prashantbhandary/mspmo-baord/images/3d-top.png

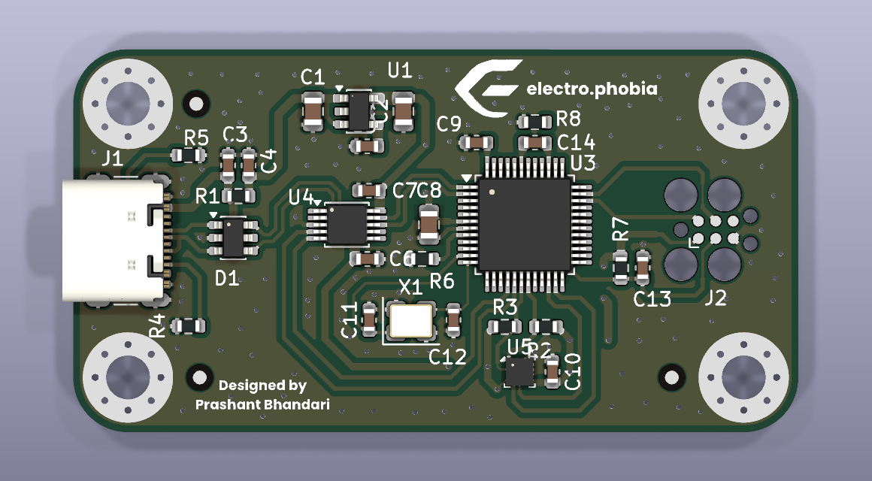
images/3d-top.png
