prashantbhandary/mspmo-baord/mspmo-baord.kicad_pcb

## KiCad design mspmo-baord.kicad_pcb (2026-10-18)

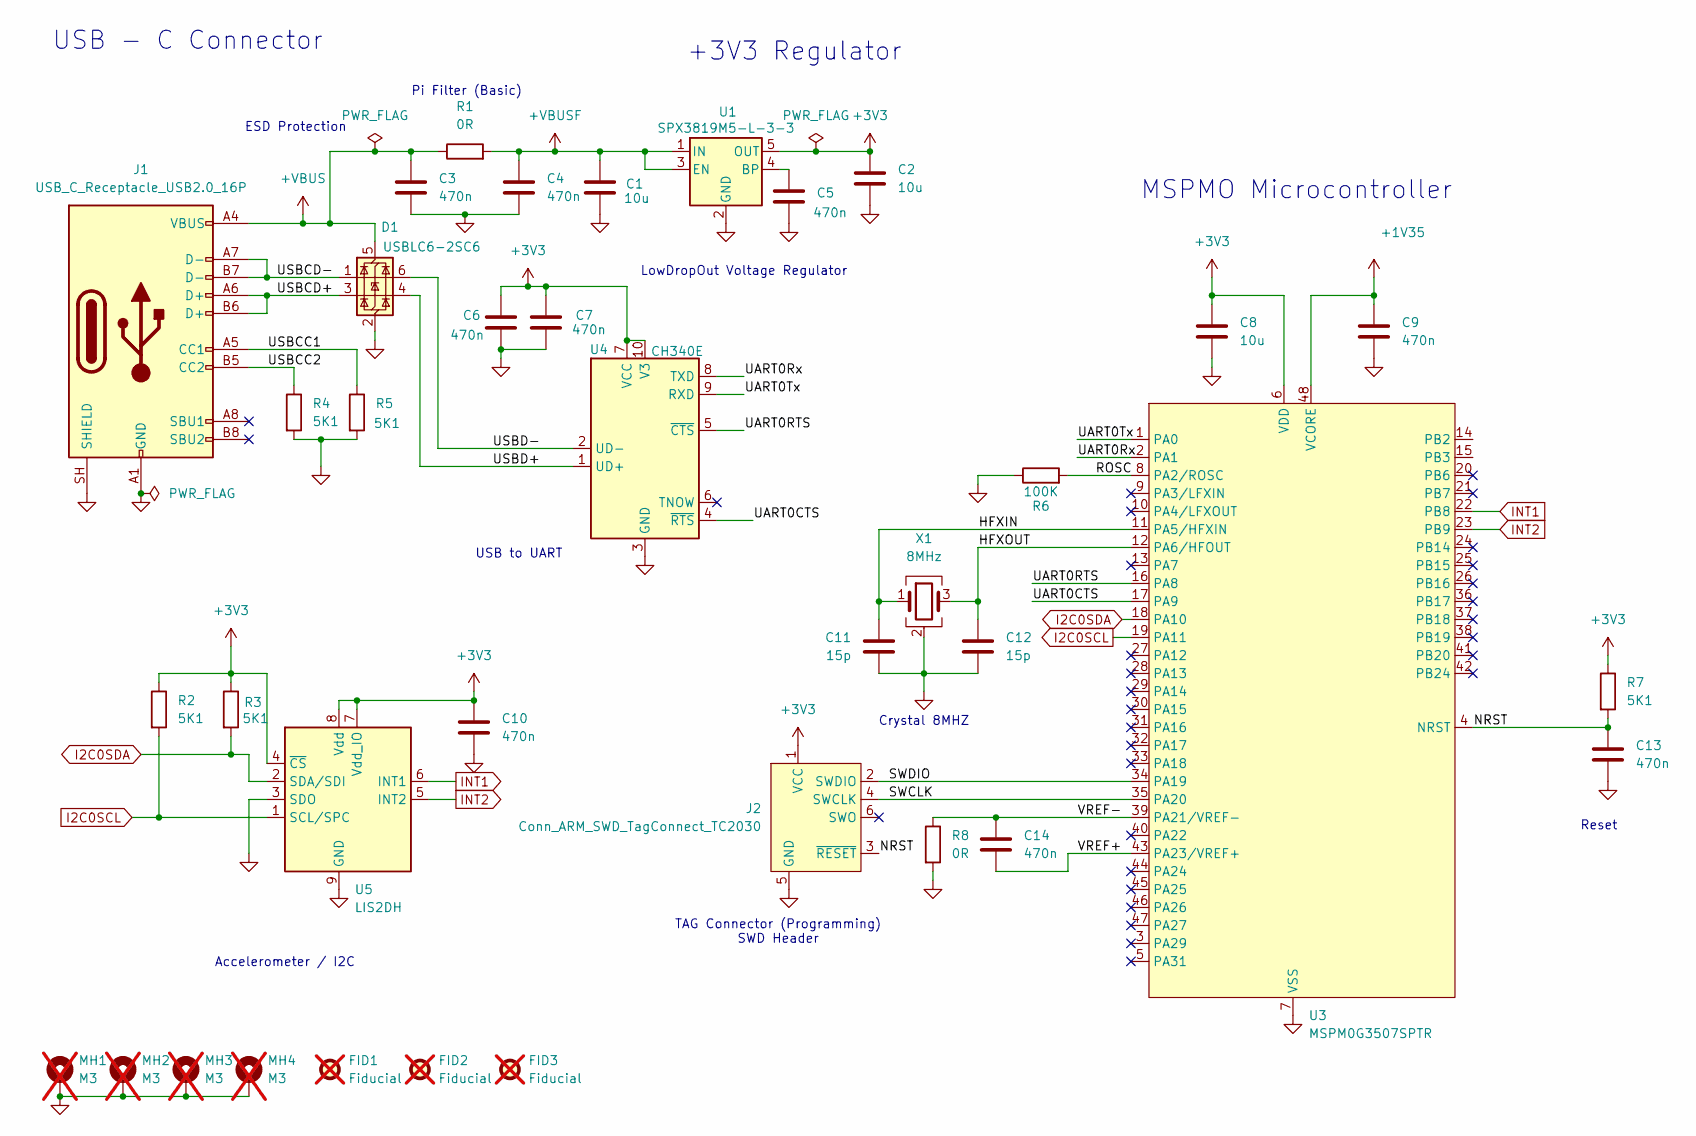
[picture p3: schematic mspmo-baord.kicad_sch, MSPM0 PCB]

Parts:
C1, C2, C8: 10u; C_0805_2012Metric; Manufacture Part Number CL21A106KAYNNNE; LCSC C15850
C3, C4, C5, C6, C7, C9, C10, C13, C14: 470n; C_0603_1608Metric; Manufacture Part Number CC0603KRX7R9BB474; LCSC C513577
C11, C12: 15p; C_0603_1608Metric; Manufacture Part Number CC0603KRX7R9BB474; LCSC C513577
D1: USBLC6-2SC6; SOT-23-6
FID1, FID2, FID3: Fiducial; Fiducial_1mm_Mask2mm; not fitted
J1: USB_C_Receptacle_USB2.0_16P; USB_C_Receptacle_GCT_USB4105-xx-A_16P_TopMnt_Horizontal
J2: Conn_ARM_SWD_TagConnect_TC2030; Tag-Connect_TC2030-IDC-FP_2x03_P1.27mm_Vertical
MH1, MH2, MH3, MH4: M3; MountingHole_3.2mm_M3_Pad_Via; not fitted
R1, R8: 0R; R_0603_1608Metric
R2, R3, R4, R5, R7: 5K1; R_0603_1608Metric
R6: 100K; R_0603_1608Metric; Manufacture Part Number RS73F1JTTD1003B; LCSC C4118779
U1: SPX3819M5-L-3-3; SOT-23-5
U3: MSPM0G3507SPTR; LQFP-48_7x7mm_P0.5mm; Manufacture Part Number MSPM0G3507SPTR; LCSC C22362630
U4: CH340E; MSOP-10_3x3mm_P0.5mm
U5: LIS2DH; LGA-14_2x2mm_P0.35mm_LayoutBorder3x4y
X1: 8MHz; Crystal_SMD_3225-4Pin_3.2x2.5mm

Connections:
+1V35: C9.1, U3.48 (VCORE)
+3V3: C2.2, C6.1, C7.1, C8.2, C10.1, J2.1 (VCC), R2.1, R3.1, R7.1, U1.5 (OUT), U3.6 (VDD), U4.7 (VCC), U4.10 (V3), U5.4 (~CS), U5.7 (Vdd_IO), U5.8 (Vdd)
+VBUS: C3.1, D1.5 (VBUS), J1.A4 (VBUS), J1.A9 (VBUS), J1.B4 (VBUS), J1.B9 (VBUS), R1.1
+VBUSF: C1.2, C4.1, R1.2, U1.1 (IN), U1.3 (EN)
/HFXIN: C11.1, U3.11 (PA5/HFXIN), X1.1
/HFXOUT: C12.1, U3.12 (PA6/HFOUT), X1.3
/NRST: C13.1, J2.3 (~RESET), R7.2, U3.4 (NRST)
/ROSC: R6.2, U3.8 (PA2/ROSC)
/SWCLK: J2.4 (SWCLK), U3.35 (PA20)
/SWDIO: J2.2 (SWDIO), U3.34 (PA19)
/UART0CTS: U3.17 (PA9), U4.4 (~RTS)
/UART0RTS: U3.16 (PA8), U4.5 (~CTS)
/UART0Rx: U3.2 (PA1), U4.8 (TXD)
/UART0Tx: U3.1 (PA0), U4.9 (RXD)
/USBCC1: J1.A5 (CC1), R5.1
/USBCC2: J1.B5 (CC2), R4.1
/USBCD+: D1.3 (I/O2), J1.A6 (D+), J1.B6 (D+)
/USBCD-: D1.1 (I/O1), J1.A7 (D-), J1.B7 (D-)
/USBD+: D1.4 (I/O2), U4.1 (UD+)
/USBD-: D1.6 (I/O1), U4.2 (UD-)
/VREF+: C14.2, U3.43 (PA23/VREF+)
/VREF-: C14.1, R8.1, U3.39 (PA21/VREF-)
GND: C1.1, C2.1, C3.2, C4.2, C5.2, C6.2, C7.2, C8.1, C9.2, C10.2, C11.2, C12.2, C13.2, D1.2 (GND), J1.A1 (GND), J1.A12 (GND), J1.B1 (GND), J1.B12 (GND), J1.SH (SHIELD), J2.5 (GND), MH1.1 (1_1), MH2.1 (1_1), MH3.1 (1_1), MH4.1 (1_1), R4.2, R5.2, R6.1, R8.2, U1.2 (GND), U3.7 (VSS), U4.3 (GND), U5.3 (SDO), U5.9 (GND), U5.10 (GND), U5.11 (GND), U5.12 (GND), U5.13 (GND), U5.14 (GND), X1.2 (G), X1.4 (G)
I2C0SCL: R2.2, U3.19 (PA11), U5.1 (SCL/SPC)
I2C0SDA: R3.2, U3.18 (PA10), U5.2 (SDA/SDI)
INT1: U3.22 (PB8), U5.6 (INT1)
INT2: U3.23 (PB9), U5.5 (INT2)
unnamed: C5.1, U1.4 (BP)

Notes on the sheet:
ESD Protection
MSPMO Microcontroller
Crystal 8MHZ
Accelerometer / I2C
Reset
TAG Connector (Programming) SWD Header
+3V3 Regulator
LowDropOut Voltage Regulator
USB to UART
Pi Filter (Basic)
USB - C Connector

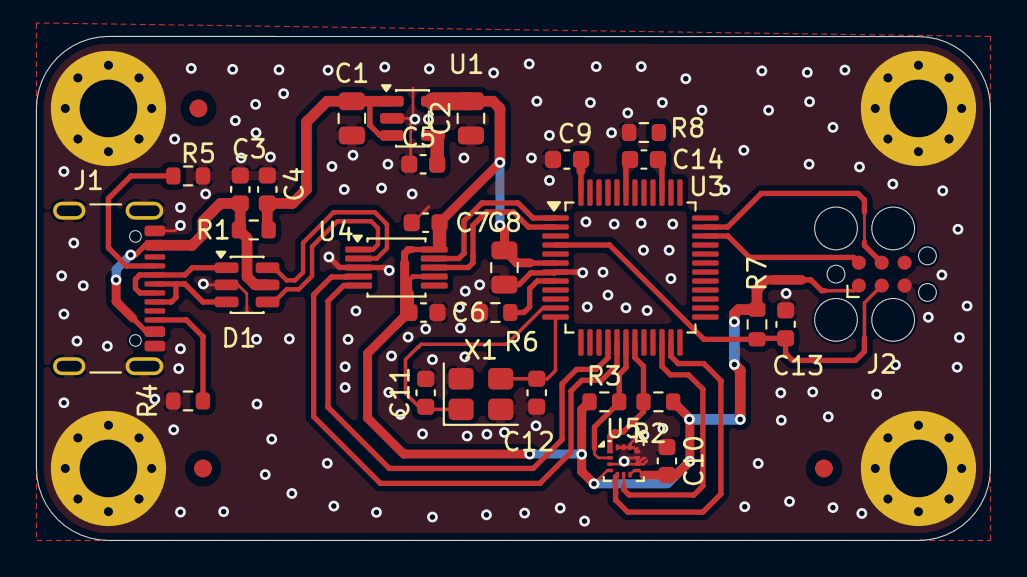
[picture p4: board mspmo-baord.kicad_pcb from above]

Board: 2 copper layers, 53.0 x 28.0 mm, 37 parts (0 on the bottom side), 28 nets.
