prashantbhandary/mspmo-baord/(commit log)

2026-10-17 schematics files
    [mspmo-baord.kicad_pcb, mspmo-baord.kicad_sch]
2026-10-18 pcb files
    [mspmo-baord.kicad_pcb, mspmo-baord.kicad_sch]
2026-10-20 Document the board in the README and add renders
